Saur0o0n/PlantGuardian/(commit log)

2020-08-03 Add documentation and humidity,temperaure,pressure and light sensor support
2020-08-19 Kind if "finished product" - add all remanining sensor, add water level sensor - put to production in my case
2020-09-22 New release v1.1 - fully operational with new OTA update, voltage measuring and power optimizations
2021-06-23 Added BMP sensor (was only BME) - requires function change in code
